oliviazzzu/minimal-embodiment/olfaction/results/feature_scatter.png

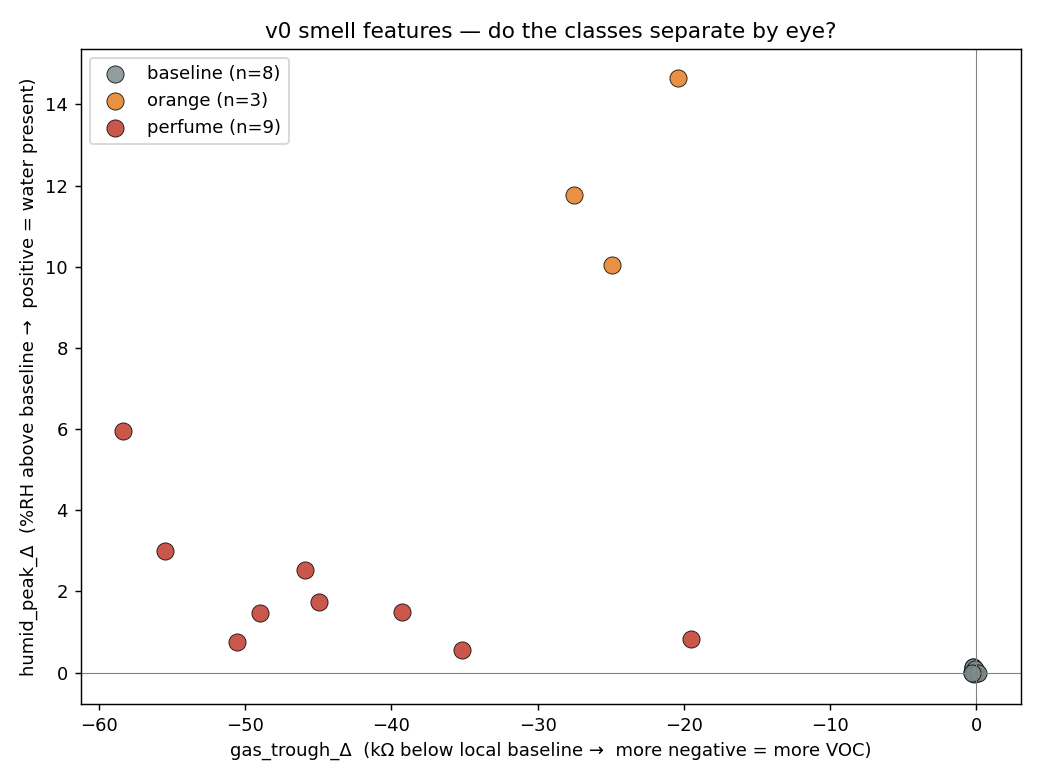
olfaction/results/feature_scatter.png
