oliviazzzu/minimal-embodiment/(commit log)

2026-04-28 Initial commit: bridge service and ESP32 firmware accompanying the paper "A Minimal Self-Perceiving Embodiment for Large Language Models".
2026-04-28 Add the §6.3 validation dataset and update README accordingly.
    The 660-trial randomized run that backs Tables 3 and 4 of the paper is now
    checked into data/ — raw JSONL plus the two summary CSVs — so the Code and
    Data Availability claim in the manuscript is satisfied directly from the
    repository.
    [loops_audio.csv, loops_haptic.csv]
2026-04-30 Add Zenodo DOI badge to README header.
    The badge image is rendered straight from Zenodo and links to the
    deposit landing page, giving visitors a one-glance signal that the
    work is archived and citable.
2026-05-09 Add docs/BUILD_GUIDE.md: step-by-step replication walkthrough.
    Phase 1-10 narrative covering BME280/688 first read, light + motion,
    OLED face, KY-006 voice, DRV2605L + ERM touch, INMP441 audio
    self-perception loop, MPU-6050 haptic loop, capstone interaction, full
    API reference, and cloudflared remote bridge. Each phase ends in an
    explicit emotional milestone. Includes lived troubleshooting (BH1750
    ADDR-floating, INMP441 pin assignment, DRV2605L library selection,
    HAPTIC_EFFECTS name typos), full named-preset listings (15
    expressions, 10 beeps, 11 haptic effects, 5 sensor aliases),
    authentication via Authorization header, and a section briefing AI
    agents who help humans build the system.
    REA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
2026-05-09 Split the researcher-routing sentence into its own paragraph.
    "This guide is the longer 'build it from zero' path" was a self-referential
    frame, not a continuation of the researcher pointer above it; sharing a
    paragraph with the routing sentence read as a trailing afterthought.
2026-05-16 Port /melody endpoint and BME688 gas-resistance support from dev tree.
    Brings the public bridge + firmware up to the live deployment state.
    /melody (bridge):
    - New endpoint /melody accepts ?song=<name> or ?notes=freqXduration,...
    - SONGS table ships twinkle_part1 / _part2 / _full as starter melodies
    - MAX_COMMAND_QUEUE raised 8 → 64 to fit a single melody burst
    - MAX_MELODY_NOTES = 64 (aligned with the queue), so all melody paths
    share one upper bound — server-side songs and user-submitted CSV alike
    - No firmware change for melody — it just enqueues N regular beep
    commands, which the existing beep handler already plays one at a time
    BME688 (bridge + firmware):
    - SensorReading.env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
2026-06-29 Redesign FACE_LOVE and default expression
    - FACE_LOVE: parametric outline hearts at cheeks + soft arc eyes + smile
    - FACE_DEFAULT: straight mouth → gentle smile arc
    [sensor_body.ino]
2026-06-29 Add FSR 402 touch sensor and NTC thermistor support
    - FSR on GPIO 36: raw ADC + touch threshold detection
    - NTC 10K (MF52D) on GPIO 39: Steinhart-Hart skin temperature
    - Guard against ADC 0/4095 in thermistor init (prevents divide-by-zero)
    - Both report via POST query params (fsr_raw, touch_detected, skin_temp_c)
    [sensor_body.ino]
2026-06-30 Add olfaction directory: scent classifier v0.1
    RandomForest classifier (3 classes: baseline / orange / perfume) trained on
    BME688 signed-delta features with three-level group-aware cross-validation
    (96–100% accuracy, no session-level leakage). Includes training/evaluation
    scripts, feature data, trained model, validation results, and robustness checks.
    [features.csv]
2026-06-30 Update BUILD_GUIDE and bridge: add Phase 8, update expression whitelist
    BUILD_GUIDE: new Phase 8 (FSR touch + NTC thermistor), renumber phases,
    update modality/expression counts, fix scripts/up.sh → scripts/serve.sh,
    clarify Phase 9 component count, update olfaction Next Steps to reference
    the olfaction/ directory.
    Bridge: add two new expressions to FACE_EXPRESSIONS whitelist (15 → 17).
2026-08-10 bridge: melody travels as one command with per-note gaps
    Queueing a song as N beep commands let the poll cadence set the tempo:
    every note waited a full poll round-trip, and over a TLS tunnel (where
    each round-trip is a reconnect, measured 1.1-1.6s) melodies shredded
    into stutter. The whole score now ships as a single melody command —
    CSV of freqXdurXgap tokens — and the firmware plays it with local
    timing. Measured on hardware: a 2.5s five-note piece plays in exactly
    its notated 2536ms, against 6.3s of stutter before.
    The silence after each note is a first-class part of the score: per-note
    Xgap in inline CSV, gap_ms as the call-level default, frequency 0 as a
    rest. Without explicit gap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
2026-08-10 firmware: reuse the poll connection across commands
    The command poll task built a fresh HTTPClient — and with it a fresh
    TLS session — every round. Each mbedTLS handshake costs ~1-1.5s on an
    ESP32, so every face/haptic/beep command arrived with over a second of
    dead air in front of it, and consecutive commands were spaced by
    handshakes. One client now lives for the whole task with setReuse;
    setURL swaps the per-round query without dropping the connection, and
    only transport errors tear the session down.
    Measured on hardware: command round-trip 1330-1650ms before, 164-237ms
    after; a command queued while the long-poll is parked is delivered in
    under 30ms.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
    [sensor_body.ino]
2026-08-11 firmware: clear echo slots only after confirmed delivery
    Echo piggyback params were consumed while building the poll URL, so a
    transport failure on that request silently dropped the measurement.
    Keep the slot valid until the poll returns 2xx; on failure the echo
    rides the next round instead.
    [sensor_body.ino]
2026-08-18 Add touch sensing: firmware touch events, bridge reception, recent_touch
    The firmware segments FSR readings into discrete touches (press-release)
    and ships the most recent one with the sensor post — single slot, latest
    wins, cleared only once the bridge confirms receipt, the same ferry as
    the beep and haptic echoes. The bridge now parses the touch fields it
    previously dropped (fsr_raw, touch_detected, skin_temp_c) and serves the
    latest touch as recent_touch in /sensor/status and room snapshots.
    Nothing is persisted; a bridge restart forgets. BUILD_GUIDE updated to
    match, including the skin-temperature verification range (36-39 C).
2026-08-18 firmware: DNS fallback resolver on lwIP slot 2
    Some routers' DNS stops answering while the WiFi link stays up, leaving
    every bridge-host lookup to fail until the router is rebooted. Park
    8.8.8.8 in lwIP's third DNS server slot after the first connect and
    after every reconnect: when a lookup times out, lwIP walks the slots,
    the fallback answers, and the refilled DNS cache recovers the link with
    no reboot on either side.
    [sensor_body.ino]
2026-08-19 firmware: hysteresis on touch segmentation
    Press begins above 100 ADC counts, release below 80. The 20-count band
    keeps readings that hover near a single threshold from splitting one
    sustained contact into many short events.
    [sensor_body.ino]
2026-08-19 olfaction: re-parameterise the pipeline to the 10 s sensor cadence
    One row arrives per 10 s sensor post. Feature windows are now expressed
    at that cadence (60-row exposure, 30-row baseline reference, 15-row
    slope head; wall-clock semantics unchanged), the published features and
    model are regenerated by the updated pipeline, and the evaluation tables
    carry the rerun numbers. Accuracies reproduce within seed variance.
    [features_v0.2.csv]
2026-08-19 bridge: deploy the olfactory classifier
    The bridge now runs the 3-class scent classifier from olfaction/: each
    sensor post contributes one row to a 90-row sliding window (30 baseline
    + 60 exposure, matching the training pipeline), and the result rides in
    /sensor/status and room snapshots as a smell block — collecting until
    the window fills, then label, confidence, and per-class probabilities.
    Below 50% confidence the label is "unknown". Inference is a plain
    TypeScript forward pass reading the model JSON from olfaction/models/.
2026-08-19 docs: lead with the BME688 now that smell is a first-class sense
    The guide recommended the BME280 with the BME688 as an aside; with the
    olfactory classifier deployed, new builds should start from the BME688
    (same wiring, a few euros more, gas channel included). The BME280 stays
    fully supported — everything except smell — and the API note now says
    its smell block staying at "collecting" is expected.
2026-08-19 docs: guide updates for the deployed olfactory classifier
    The Phase 1 example gains the gas_resistance_kohms line, the sensor
    notes state the BME688/BME280 difference plainly, Next steps marks
    the classifier as deployed rather than pending, the modality count
    reads nine (eight with a BME280), and a version-dependent section
    number and a stale firmware line count are refreshed.
2026-08-19 olfaction: make the classifier opt-in
    The bridge runs the classifier only when started with ENABLE_SMELL=1;
    by default the smell field is absent and the startup banner says how to
    enable it. The bundled model was trained on controlled near-sensor
    exposures from a single BME688 and cross-device generalisation is
    unvalidated — the model card now states these exposure conditions, and
    the README and guide describe smell as an optional experimental
    prototype. Also restores the guide's BME280-first ordering in the three
    spots earlier edits flipped.
2026-08-21 bridge: read query params on POST as well as GET
    POST requests previously parsed only the JSON body; anything in the
    query string was silently dropped. `POST /haptic?wait_echo=true`
    therefore fired the effect without selecting the measured-echo path —
    the motor ran but no echo was ever produced — while the identical call
    as GET worked. Merge query params under the body (body wins on
    collision) so both forms honour the documented `?wait_echo=true`
    interface on every write endpoint.
2026-08-21 haptic: restore unconditional self-perception
    Every haptic fire now runs the full echo measurement; the "echo"
    request flag is removed from the command protocol (bridge, type,
    sketch). Since de06207, haptic echo measurement had been opt-in: only
    requests with wait_echo=true entered the measured path. wait_echo now
    controls only whether the HTTP response blocks until the echo lands.
    Echoes carry the effect name from the request whether or not the
    caller waited.
    Older firmware must be re-flashed: the bridge no longer sends the flag
    those sketches required for measurement.
    [sensor_body.ino]
